AVeryHappyTeddyBear/LeverAction/README.md

# LeverAction
A 3D printed lever action rubber band gun

Check Instructions.pdf for printing and assembly details
