AVeryHappyTeddyBear/LeverAction/STL/main body.STL

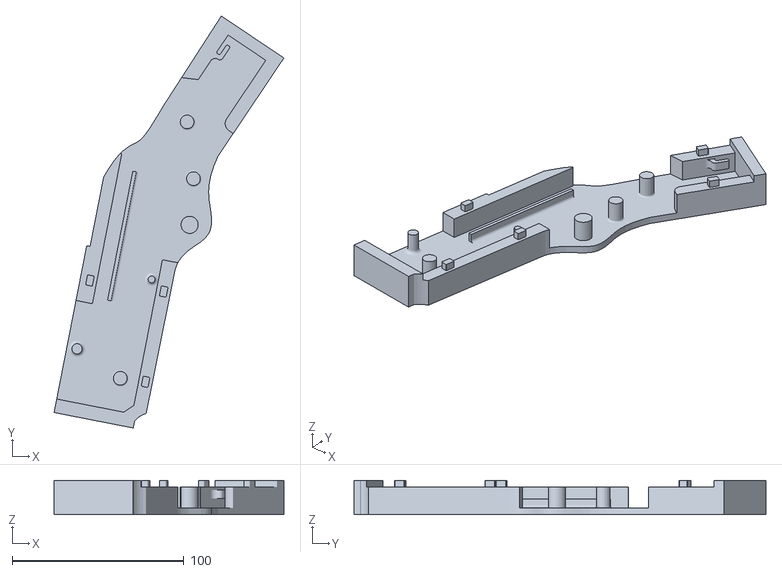
[picture p1: CAD file, 2021-01-10]
STL/main body.STL
133.9 x 240.0 x 20.0
