AVeryHappyTeddyBear/LeverAction/STL/hanger.STL

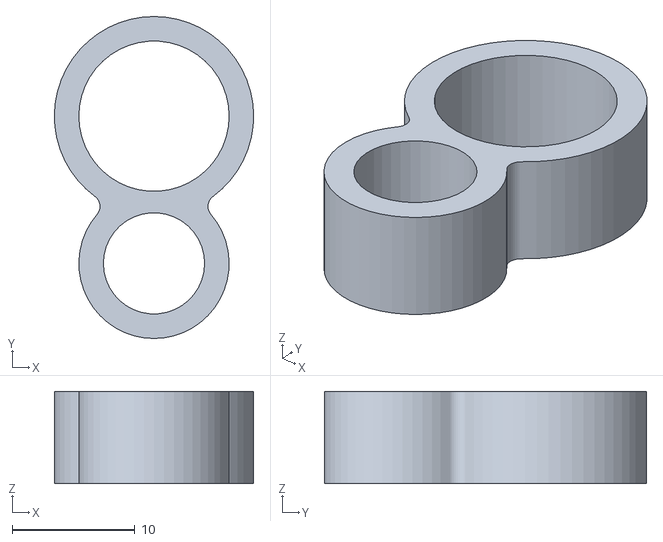
[picture p2: CAD file, 2021-01-10]
STL/hanger.STL
16.2 x 26.2 x 7.50
