AVeryHappyTeddyBear/LeverAction/STL/front body.STL

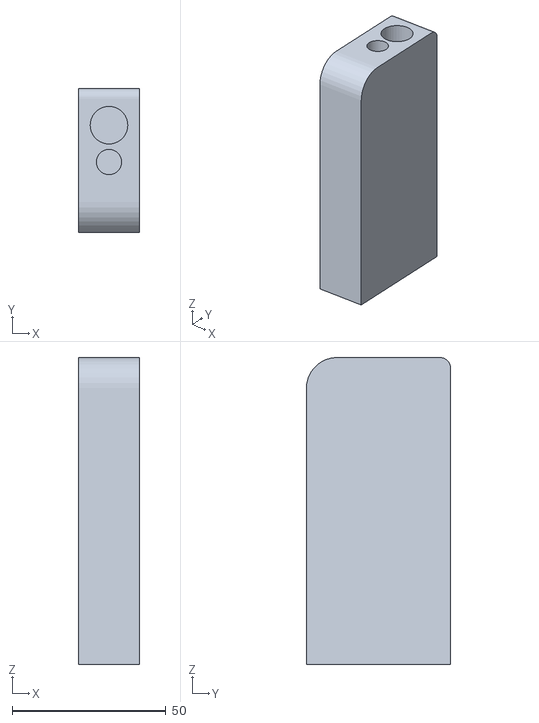
[picture p3: CAD file, 2021-01-10]
STL/front body.STL
20.0 x 47.0 x 100.0
