AVeryHappyTeddyBear/LeverAction/STL/body cover.STL

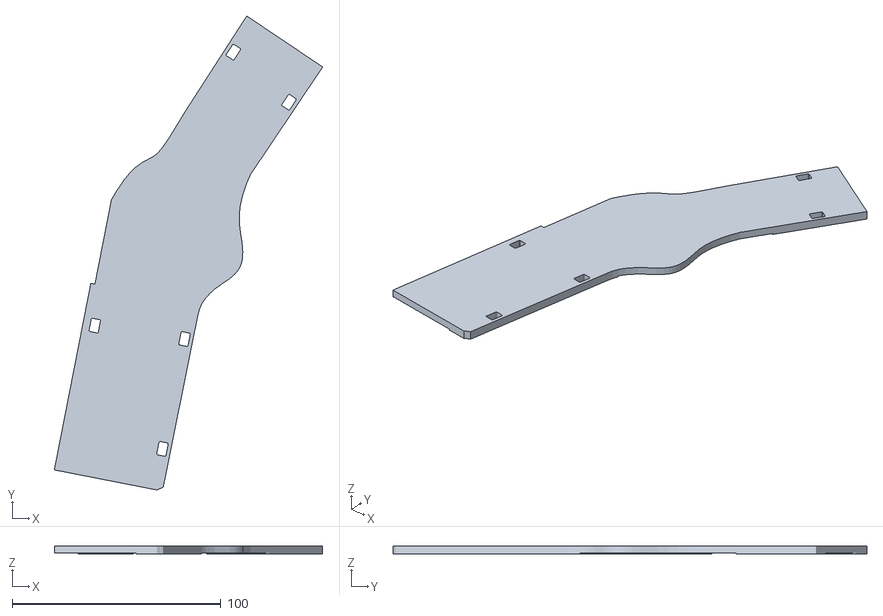
[picture p4: CAD file, 2021-01-10]
STL/body cover.STL
128.5 x 226.9 x 4.00
