AVeryHappyTeddyBear/LeverAction/STL/escapement.STL

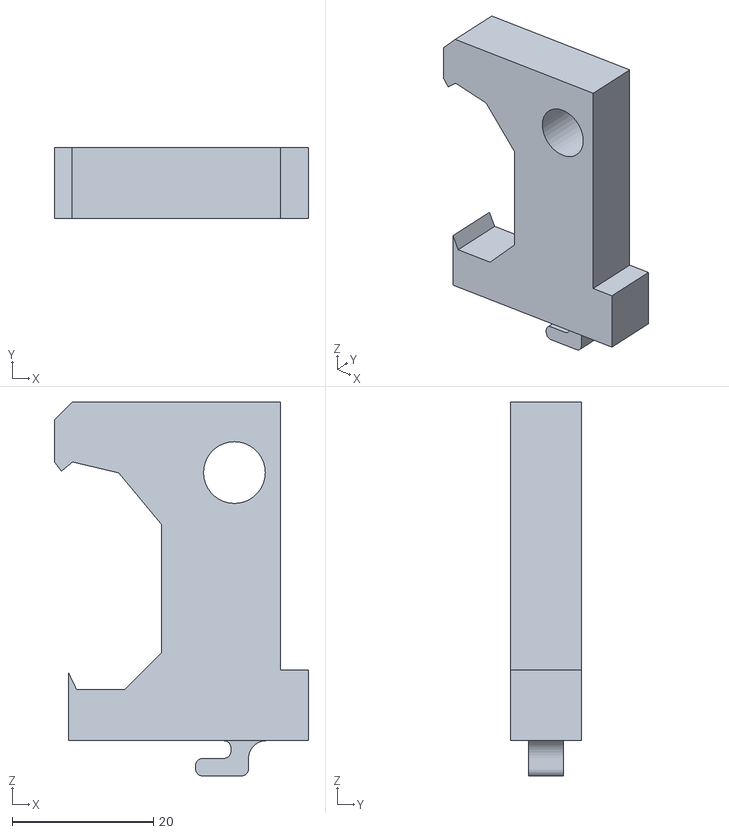
[picture p5: CAD file, 2021-01-10]
STL/escapement.STL
36.0 x 10.0 x 53.0
