AVeryHappyTeddyBear/LeverAction/STL/BarrelA.STL

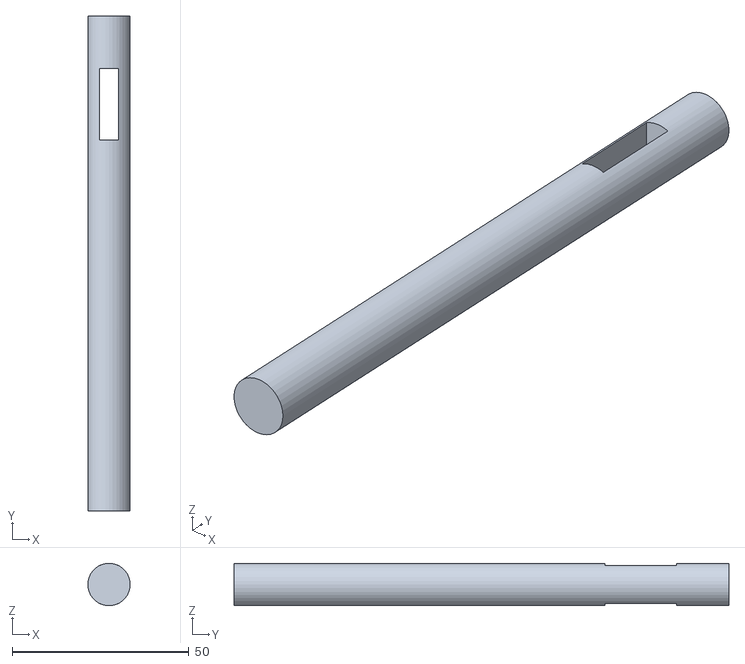
[picture p6: CAD file, 2021-01-10]
STL/BarrelA.STL
12.0 x 140.0 x 12.0
