AVeryHappyTeddyBear/LeverAction/STL/rotor.STL

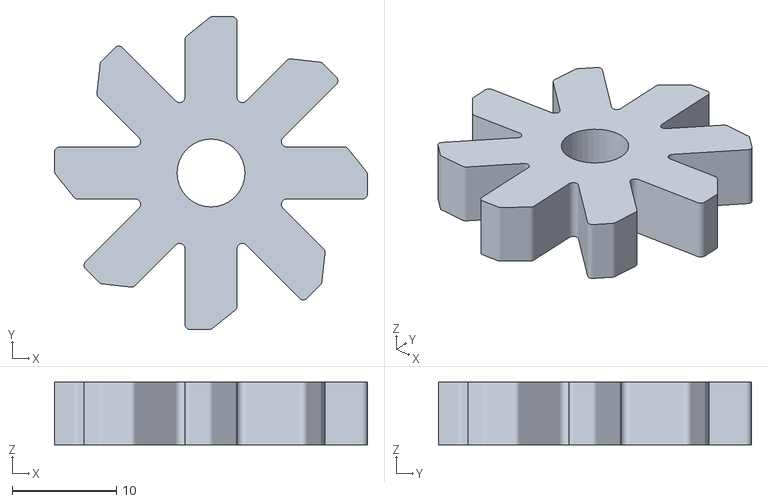
[picture p7: CAD file, 2021-01-10]
STL/rotor.STL
30.0 x 30.0 x 6.00
