AVeryHappyTeddyBear/LeverAction/STL/big_lever.STL

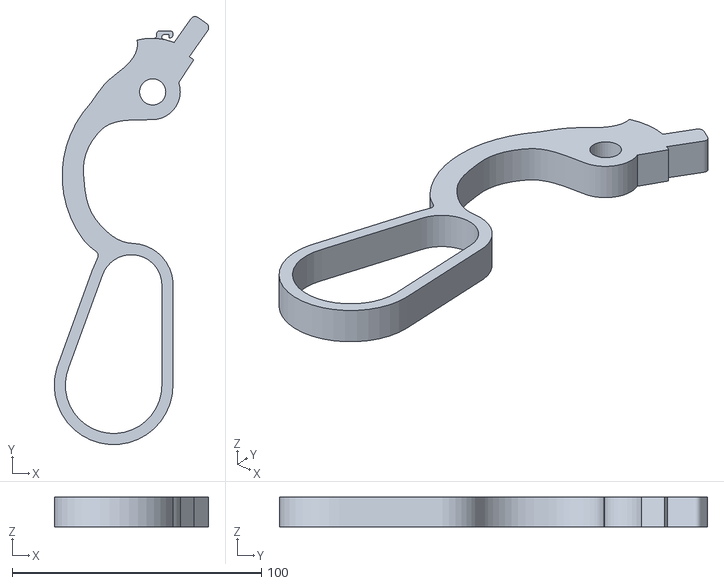
[picture p8: CAD file, 2021-01-10]
STL/big_lever.STL
62.0 x 171.6 x 12.0
