AVeryHappyTeddyBear/LeverAction/STL/BarrelB.STL

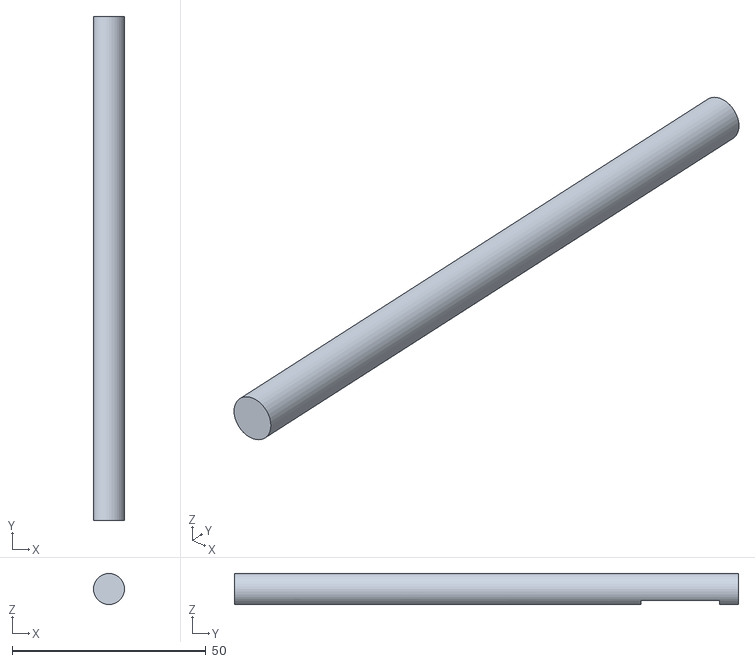
[picture p9: CAD file, 2021-01-10]
STL/BarrelB.STL
8.00 x 130.0 x 8.00
