AVeryHappyTeddyBear/LeverAction/STL/hammer.STL

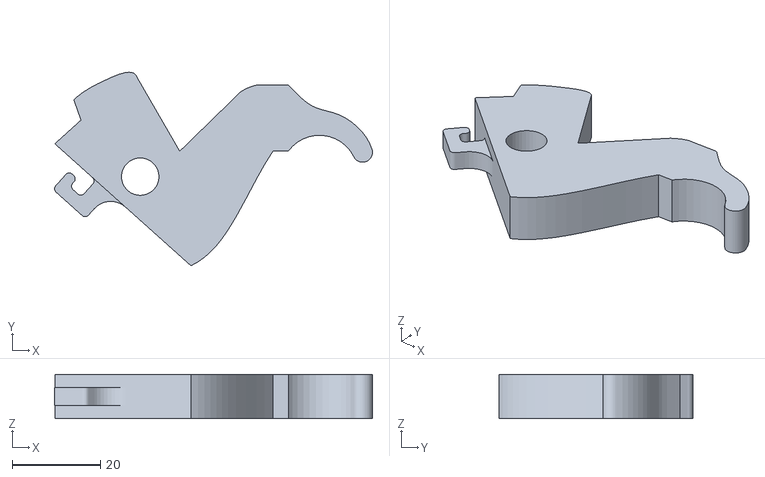
[picture p10: CAD file, 2021-01-10]
STL/hammer.STL
72.2 x 44.0 x 10.0
