AVeryHappyTeddyBear/LeverAction/STL/stock.STL

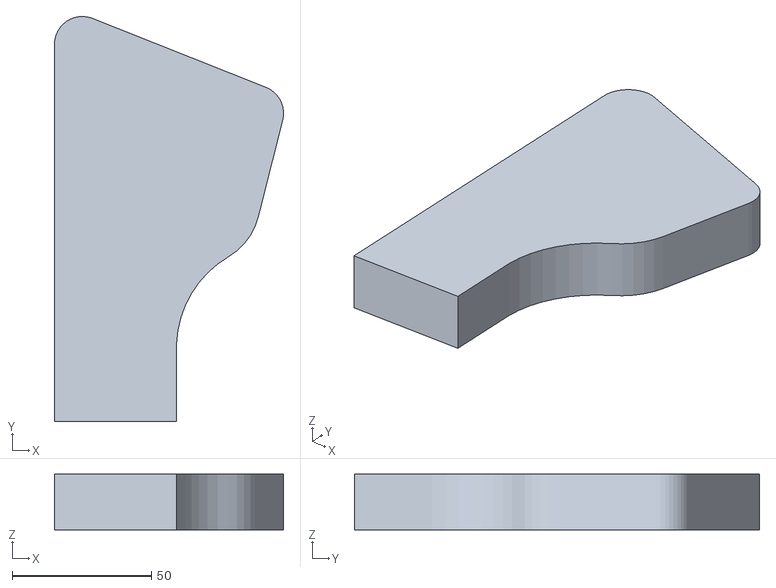
[picture p11: CAD file, 2021-01-10]
STL/stock.STL
82.4 x 145.6 x 20.0
