AVeryHappyTeddyBear/LeverAction/STL/trigger.STL

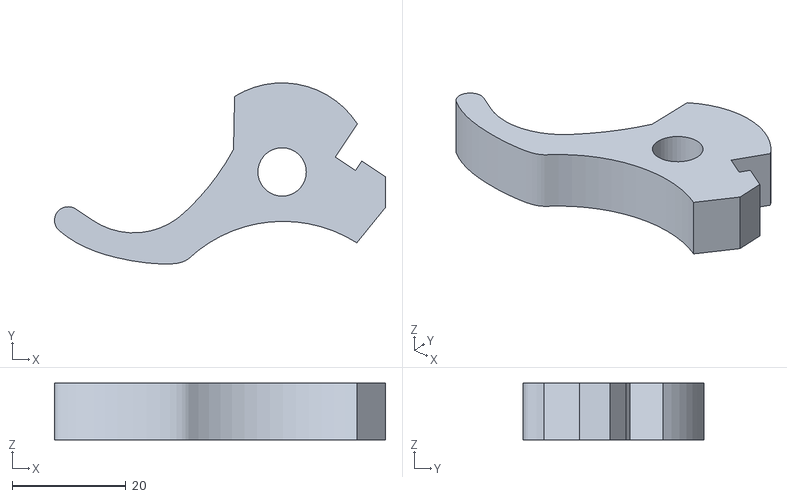
[picture p12: CAD file, 2021-01-10]
STL/trigger.STL
58.1 x 31.8 x 10.0
