AVeryHappyTeddyBear/LeverAction/STL/sight.STL

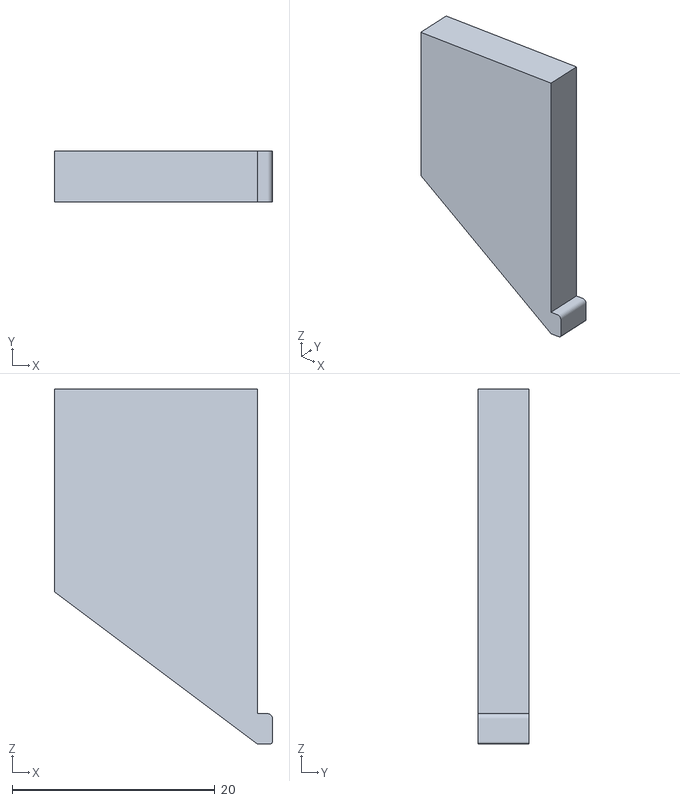
[picture p13: CAD file, 2021-01-10]
STL/sight.STL
21.5 x 5.00 x 35.0
