AVeryHappyTeddyBear/LeverAction/STL/bolt holder.STL

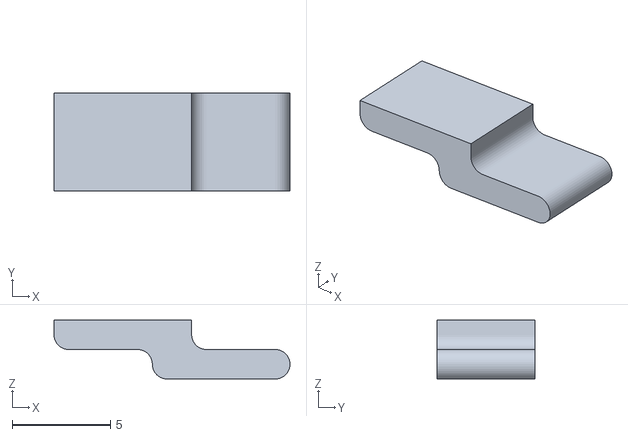
[picture p14: CAD file, 2021-01-10]
STL/bolt holder.STL
12.0 x 5.00 x 3.00
