AVeryHappyTeddyBear/LeverAction/STL/bolt.STL

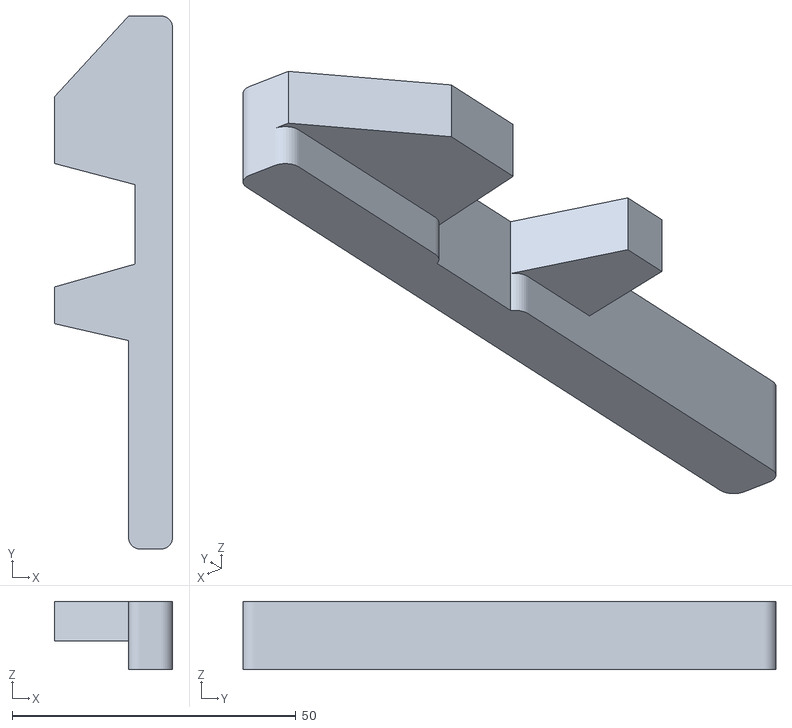
[picture p15: CAD file, 2021-01-10]
STL/bolt.STL
20.8 x 94.0 x 12.0
