AVeryHappyTeddyBear/LeverAction/(commit log)

2021-01-10 Create STL
2021-01-10 Delete STL
    whoops, did that wrong
2021-01-10 STL dump
    [BarrelA.STL, BarrelB.STL, big_lever.STL, body cover.STL, bolt holder.STL, bolt.STL, escapement.STL, front body.STL]
2021-01-10 Add files via upload
    missed one
    [hanger.STL]
2021-02-28 Updated Instructions
    Removed a typo in the parts list table and added an explicit arrow to try and prevent the stock from being attached upside down
